shotayagami/jjy-timeserver/hardware/kicad/jjy-hat-pcb-preview.png

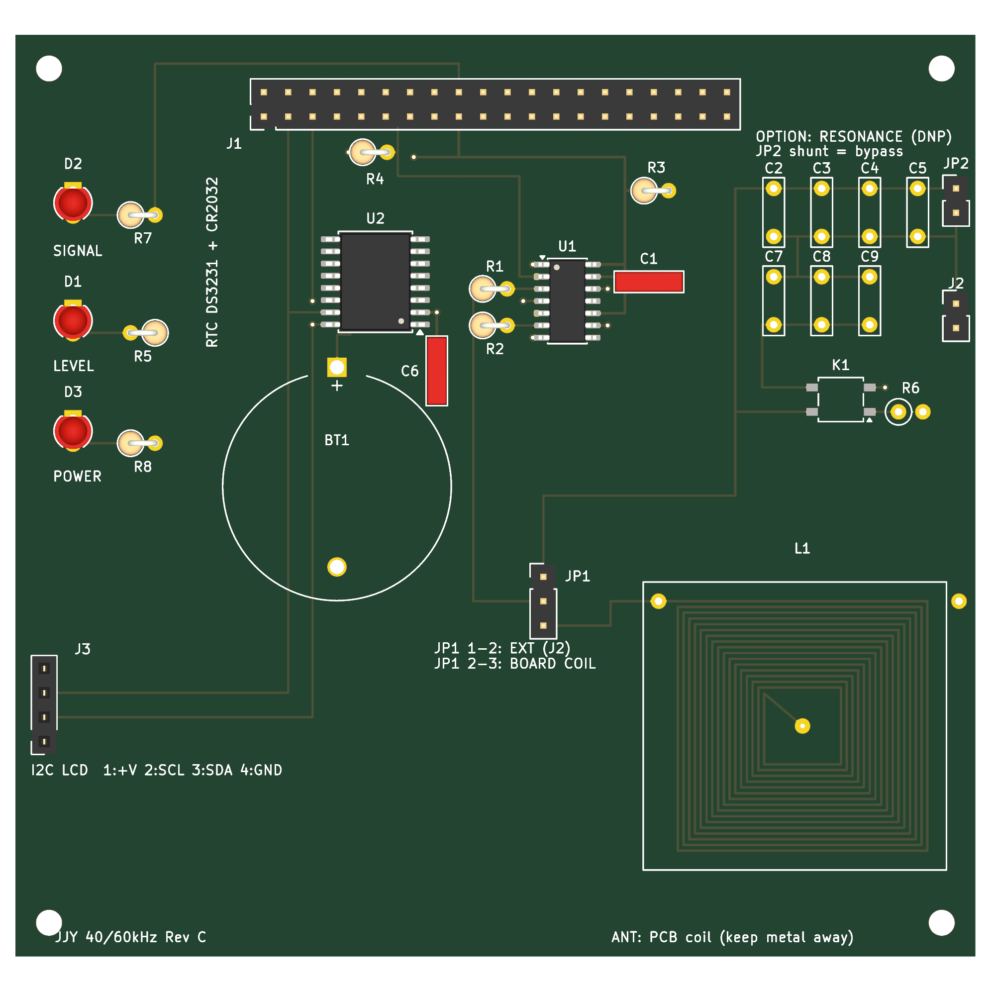
hardware/kicad/jjy-hat-pcb-preview.png
