shotayagami/jjy-timeserver/hardware/kicad/fab/jjy-hat-bom.csv

Designator | Value | Footprint | Qty | DNP
BT1 | CR2032 holder | Battery:BatteryHolder_MYOUNG_BS-07-A1BJ001_CR2032 | 1
C1,C6 | 100n | Capacitor_THT:C_Rect_L7.0mm_W2.0mm_P5.00mm | 2
C2,C7 | 4.7n C0G (DNP) | Capacitor_THT:C_Rect_L7.0mm_W2.0mm_P5.00mm | 2 | 未実装(DNP)
C3,C8,C9 | 2.2n C0G (DNP) | Capacitor_THT:C_Rect_L7.0mm_W2.0mm_P5.00mm | 3 | 未実装(DNP)
C4 | 150p C0G (DNP) | Capacitor_THT:C_Rect_L7.0mm_W2.0mm_P5.00mm | 1 | 未実装(DNP)
C5 | trim (DNP) | Capacitor_THT:C_Rect_L7.0mm_W2.0mm_P5.00mm | 1 | 未実装(DNP)
D1 | LED red | LED_THT:LED_D3.0mm | 1
D2 | LED green | LED_THT:LED_D3.0mm | 1
D3 | LED yellow | LED_THT:LED_D3.0mm | 1
J1 | GPIO 2x20 pin header (ribbon / Dupont) | Connector_PinHeader_2.54mm:PinHeader_2x20_P2.54mm_Vertical | 1
J2 | External antenna | Connector_PinHeader_2.54mm:PinHeader_1x02_P2.54mm_Vertical | 1
J3 | I2C LCD (AE-AQM1602A) | Connector_PinSocket_2.54mm:PinSocket_1x04_P2.54mm_Vertical | 1
JP1 | Antenna select | Connector_PinHeader_2.54mm:PinHeader_1x03_P2.54mm_Vertical | 1
JP2 | Resonance bypass | Connector_PinHeader_2.54mm:PinHeader_1x02_P2.54mm_Vertical | 1
K1 | AQY212SX | Package_SO:SO-4_4.4x4.3mm_P2.54mm | 1
L1 | PCB spiral coil | JJY:Coil_Spiral | 1
R1,R3,R4 | 10k | Resistor_THT:R_Axial_DIN0207_L6.3mm_D2.5mm_P2.54mm_Vertical | 3
R2 | 1.1k | Resistor_THT:R_Axial_DIN0207_L6.3mm_D2.5mm_P2.54mm_Vertical | 1
R5 | 1k | Resistor_THT:R_Axial_DIN0207_L6.3mm_D2.5mm_P2.54mm_Vertical | 1
R6 | 330 (DNP) | Resistor_THT:R_Axial_DIN0207_L6.3mm_D2.5mm_P2.54mm_Vertical | 1 | 未実装(DNP)
R7 | 330 | Resistor_THT:R_Axial_DIN0207_L6.3mm_D2.5mm_P2.54mm_Vertical | 1
R8 | 470 | Resistor_THT:R_Axial_DIN0207_L6.3mm_D2.5mm_P2.54mm_Vertical | 1
U1 | 74LVC125 | Package_SO:SOIC-14_3.9x8.7mm_P1.27mm | 1
U2 | DS3231SN# | Package_SO:SOIC-16W_7.5x10.3mm_P1.27mm | 1
