shotayagami/jjy-timeserver/hardware/kicad/fab/jlcpcb/bom.csv

Comment | Designator | Footprint | LCSC Part #
AQY212SX | K1 | SO-4_4.4x4.3mm_P2.54mm | C719754
74LVC125 | U1 | SOIC-14_3.9x8.7mm_P1.27mm | C7661
DS3231SN# | U2 | SOIC-16W_7.5x10.3mm_P1.27mm | C722469
