shotayagami/jjy-timeserver/hardware/kicad/jjy-hat.kicad_pcb

## KiCad design hardware/kicad/jjy-hat.kicad_pcb (2026-10-30)

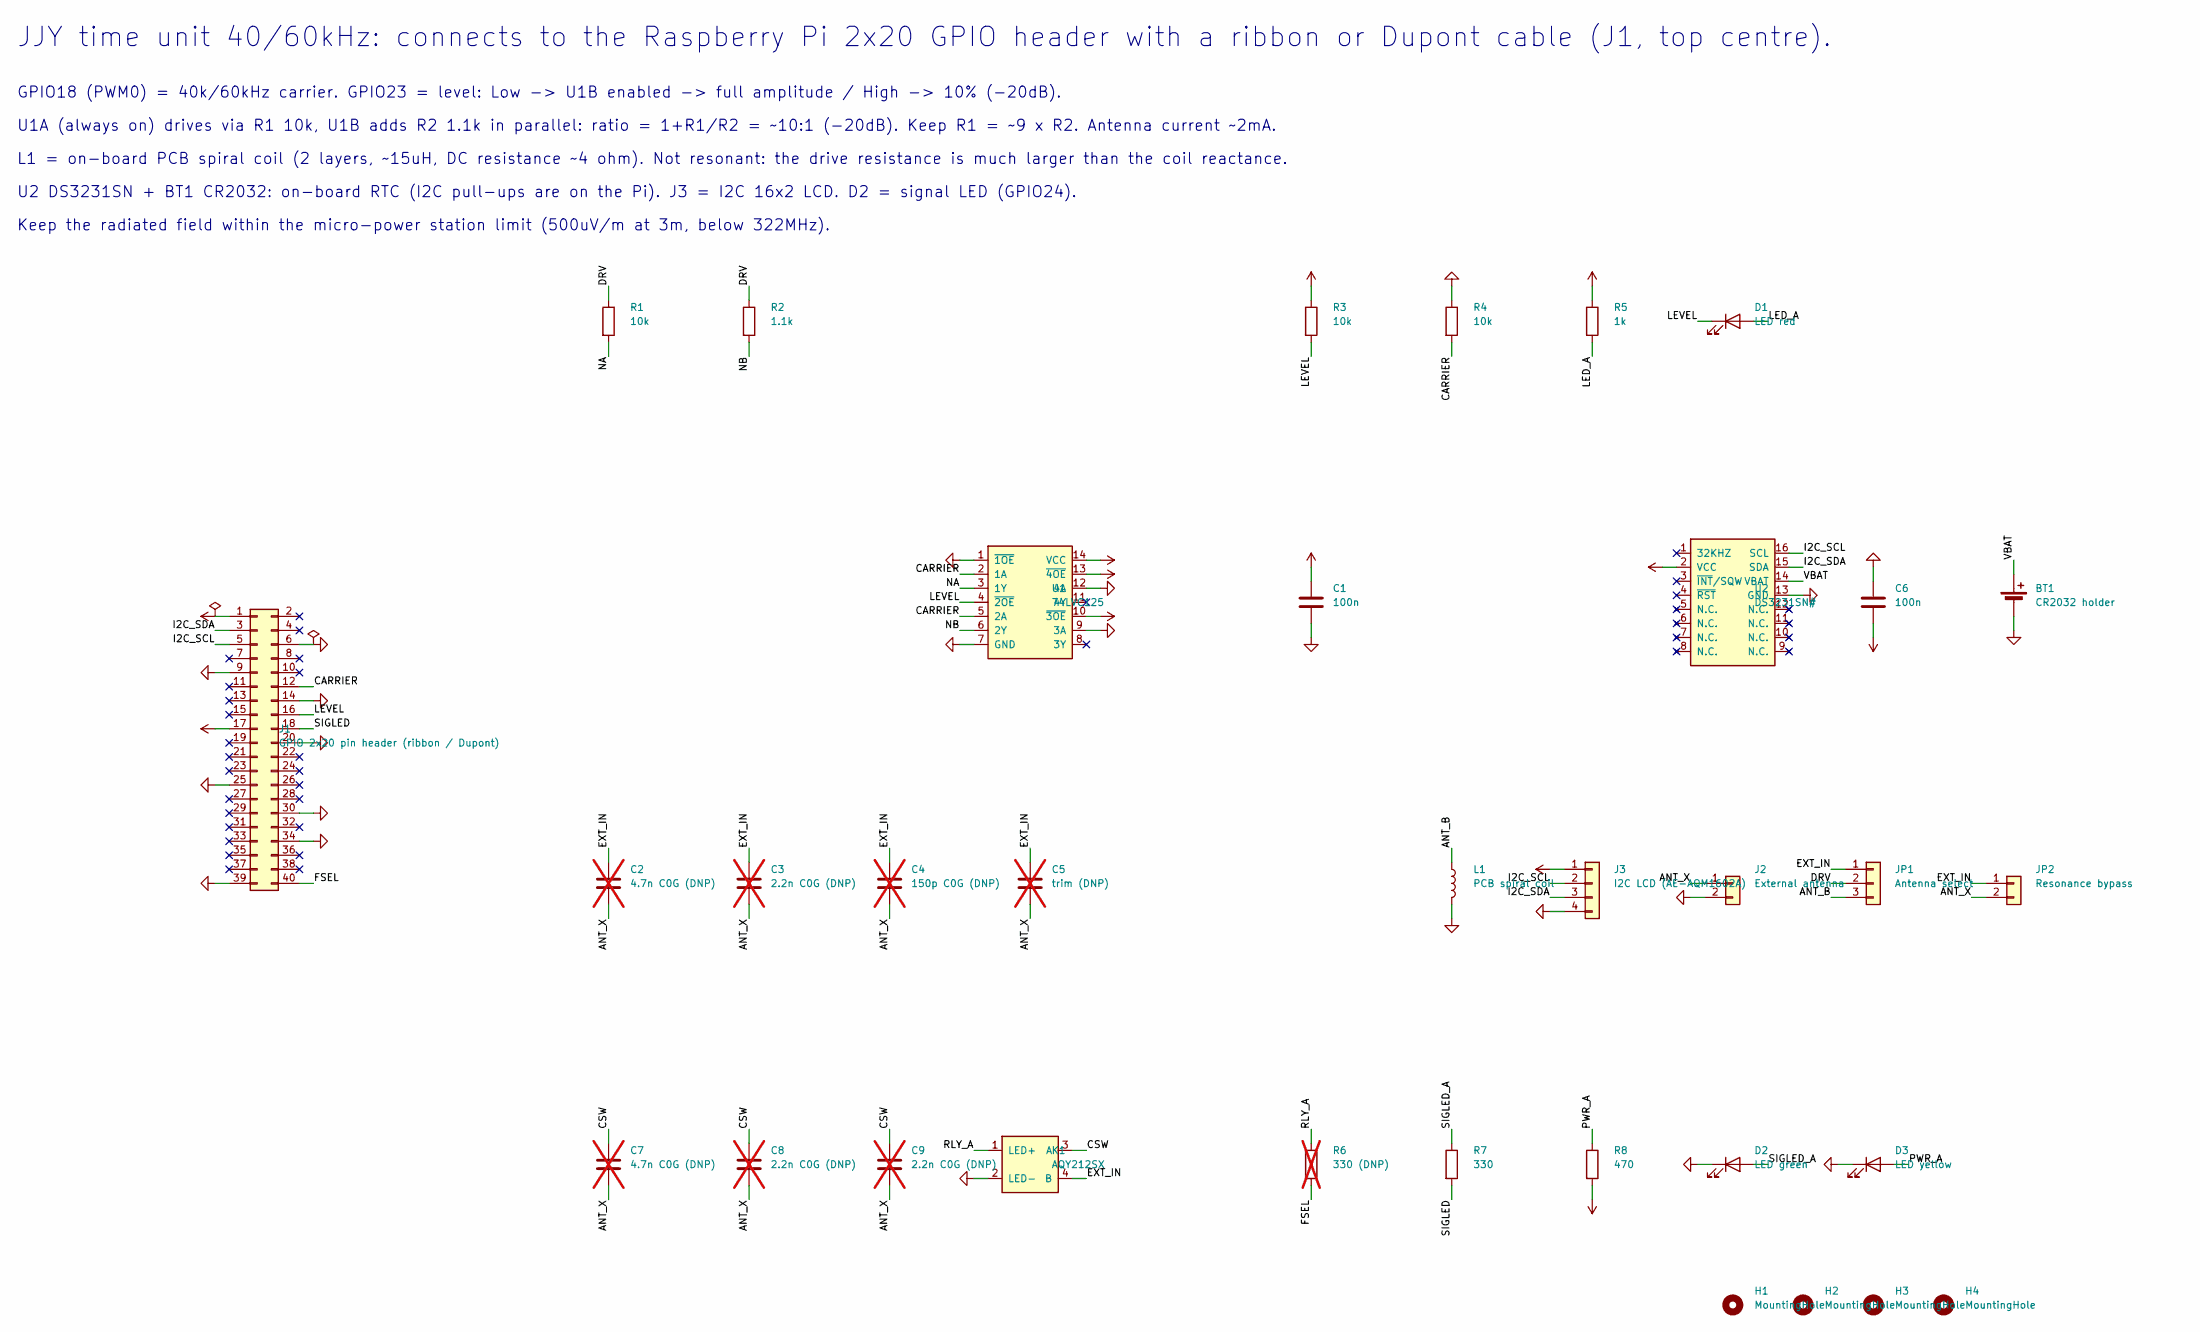
[picture p2: schematic jjy-hat.kicad_sch, JJY time unit 40/60kHz (cable to Raspberry Pi GPIO)]

Parts:
BT1: CR2032 holder; BatteryHolder_MYOUNG_BS-07-A1BJ001_CR2032
C1, C6: 100n; C_Rect_L7.0mm_W2.0mm_P5.00mm
C2, C7: 4.7n C0G (DNP); C_Rect_L7.0mm_W2.0mm_P5.00mm; not fitted
C3, C8, C9: 2.2n C0G (DNP); C_Rect_L7.0mm_W2.0mm_P5.00mm; not fitted
C4: 150p C0G (DNP); C_Rect_L7.0mm_W2.0mm_P5.00mm; not fitted
C5: trim (DNP); C_Rect_L7.0mm_W2.0mm_P5.00mm; not fitted
D1: LED red; LED_D3.0mm
D2: LED green; LED_D3.0mm
D3: LED yellow; LED_D3.0mm
H1, H2, H3, H4: MountingHole; MountingHole_2.7mm_M2.5
J1: GPIO 2x20 pin header (ribbon / Dupont); PinHeader_2x20_P2.54mm_Vertical
J2: External antenna; PinHeader_1x02_P2.54mm_Vertical
J3: I2C LCD (AE-AQM1602A); PinSocket_1x04_P2.54mm_Vertical
JP1: Antenna select; PinHeader_1x03_P2.54mm_Vertical
JP2: Resonance bypass; PinHeader_1x02_P2.54mm_Vertical
K1: AQY212SX; SO-4_4.4x4.3mm_P2.54mm
L1: PCB spiral coil; Coil_Spiral
R1, R3, R4: 10k; R_Axial_DIN0207_L6.3mm_D2.5mm_P2.54mm_Vertical
R2: 1.1k; R_Axial_DIN0207_L6.3mm_D2.5mm_P2.54mm_Vertical
R5: 1k; R_Axial_DIN0207_L6.3mm_D2.5mm_P2.54mm_Vertical
R6: 330 (DNP); R_Axial_DIN0207_L6.3mm_D2.5mm_P2.54mm_Vertical; not fitted
R7: 330; R_Axial_DIN0207_L6.3mm_D2.5mm_P2.54mm_Vertical
R8: 470; R_Axial_DIN0207_L6.3mm_D2.5mm_P2.54mm_Vertical
U1: 74LVC125; SOIC-14_3.9x8.7mm_P1.27mm
U2: DS3231SN#; SOIC-16W_7.5x10.3mm_P1.27mm

Connections:
+3V3: C1.1, C6.2, J1.1, J1.17, J3.1, R3.1, R5.1, R8.2, U1.10 (~3OE), U1.13 (~4OE), U1.14 (VCC), U2.2 (VCC)
/ANT_B: JP1.3, L1.1
/ANT_X: C2.2, C3.2, C4.2, C5.2, C7.2, C8.2, C9.2, J2.1, JP2.2
/CARRIER: J1.12, R4.2, U1.2 (1A), U1.5 (2A)
/CSW: C7.1, C8.1, C9.1, K1.3 (A)
/DRV: JP1.2, R1.1, R2.1
/EXT_IN: C2.1, C3.1, C4.1, C5.1, JP1.1, JP2.1, K1.4 (B)
/FSEL: J1.40, R6.2
/I2C_SCL: J1.5, J3.2, U2.16 (SCL)
/I2C_SDA: J1.3, J3.3, U2.15 (SDA)
/LED_A: D1.2 (A), R5.2
/LEVEL: D1.1 (K), J1.16, R3.2, U1.4 (~2OE)
/NA: R1.2, U1.3 (1Y)
/NB: R2.2, U1.6 (2Y)
/PWR_A: D3.2 (A), R8.1
/RLY_A: K1.1 (LED+), R6.1
/SIGLED: J1.18, R7.2
/SIGLED_A: D2.2 (A), R7.1
/VBAT: BT1.1 (+), U2.14 (VBAT)
GND: BT1.2 (-), C1.2, C6.1, D2.1 (K), D3.1 (K), J1.6, J1.9, J1.14, J1.20, J1.25, J1.30, J1.34, J1.39, J2.2, J3.4, K1.2 (LED-), L1.2, R4.1, U1.1 (~1OE), U1.7 (GND), U1.9 (3A), U1.12 (4A), U2.13 (GND)

Notes on the sheet:
JJY time unit 40/60kHz: connects to the Raspberry Pi 2x20 GPIO header with a ribbon or Dupont cable (J1, top centre).
GPIO18 (PWM0) = 40k/60kHz carrier. GPIO23 = level: Low -> U1B enabled -> full amplitude / High -> 10% (-20dB).
U1A (always on) drives via R1 10k, U1B adds R2 1.1k in parallel: ratio = 1+R1/R2 = ~10:1 (-20dB). Keep R1 = ~9 x R2. Antenna current ~2mA.
L1 = on-board PCB spiral coil (2 layers, ~15uH, DC resistance ~4 ohm). Not resonant: the drive resistance is much larger than the coil reactance.
U2 DS3231SN + BT1 CR2032: on-board RTC (I2C pull-ups are on the Pi). J3 = I2C 16x2 LCD. D2 = signal LED (GPIO24).
Keep the radiated field within the micro-power station limit (500uV/m at 3m, below 322MHz).

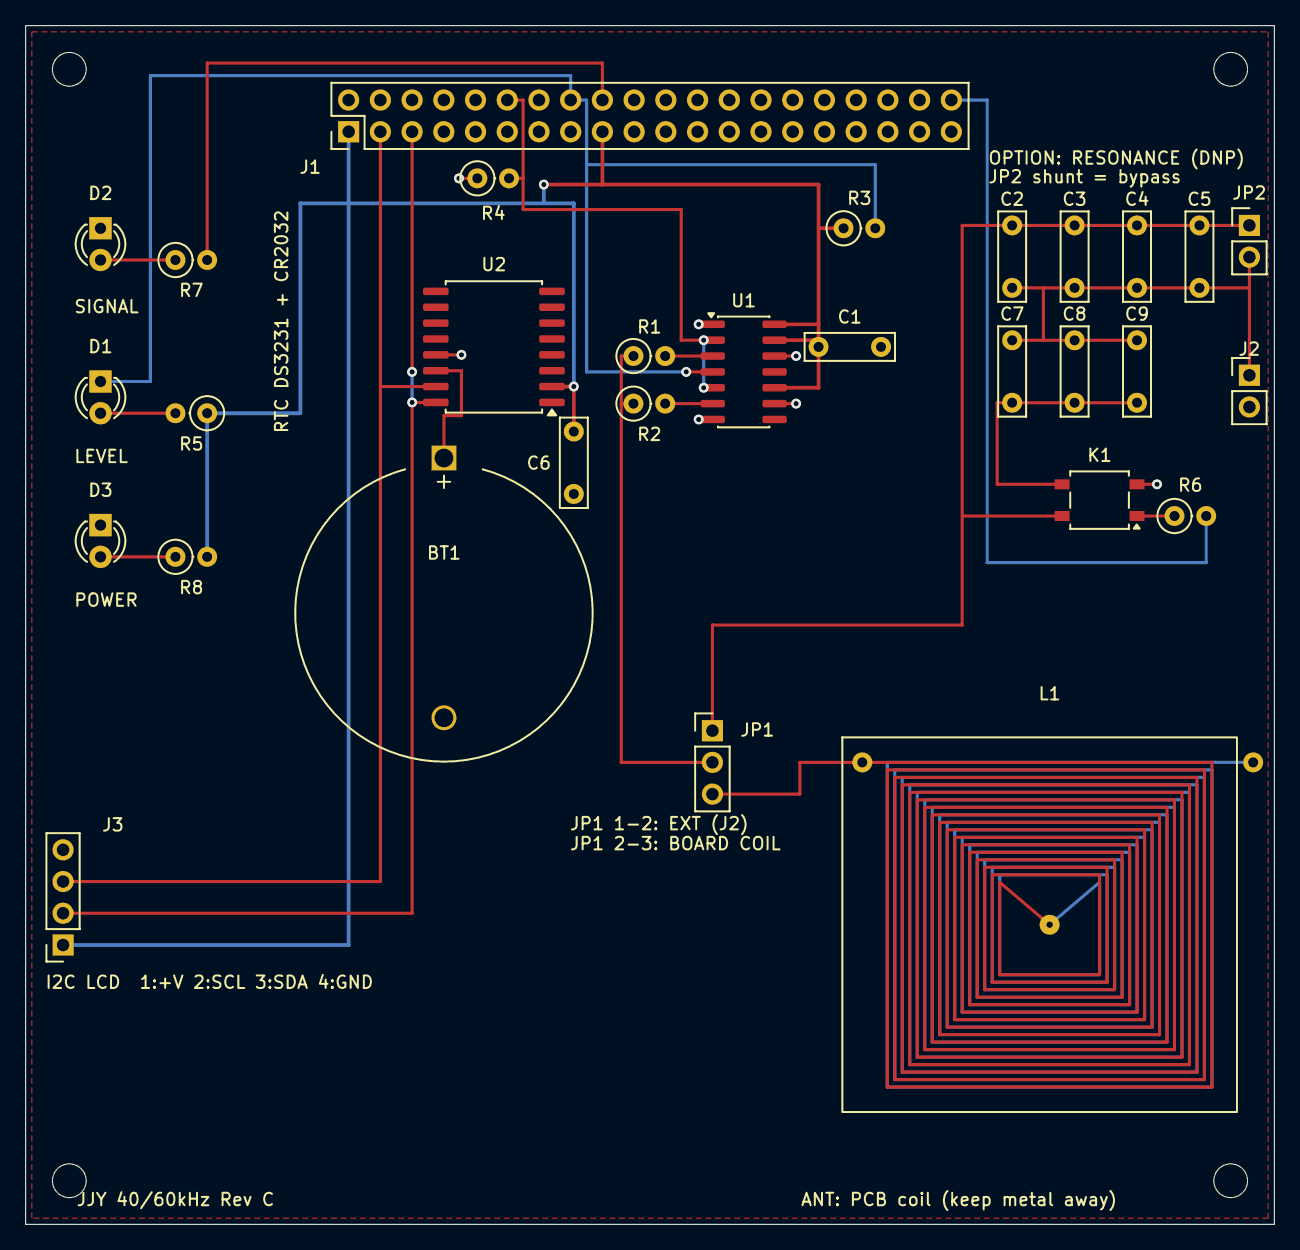
[picture p3: board jjy-hat.kicad_pcb from above]

Board: 2 copper layers, 100.0 x 96.0 mm, 34 parts (0 on the bottom side), 20 nets.
