shotayagami/jjy-timeserver/(commit log)

2026-10-29 Add JJY time server for Raspberry Pi 4: software and 40/60kHz HAT design
    - server/jjyd: JJY time code encoder, transmitter daemon, chrony sync monitor
    with optional DS3231 RTC holdover
    - hardware: KiCad project (generated by hardware/kicad/gen_kicad.py), gerbers,
    JLCPCB BOM/CPL, 40/60kHz photo-MOS band switch, on-board RTC
    - scripts/install.sh, chrony and systemd configuration
    - MIT for software, CERN-OHL-P-2.0 for hardware
    [bom.csv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]
2026-10-30 Rev C board: LCD, LEDs, PCB spiral antenna, antenna select, optional resonance
    - Leaded R/LED/C parts (hand-soldered); only U1/U2 are SMT at JLCPCB
    - 16x2 I2C LCD (J3) shows current time; signal LED (low-level period),
    level LED and power pilot LED grouped at the board's top-left
    - Antenna is an on-board PCB spiral coil; JP1 selects it or external J2
    - Optional (DNP) resonance bank + K1 40/60kHz switch for external coils
    - J1 at top-center, board 100x96 mm to fit the metal case via a cable
    - jjyd: LCD driver, signal LED, optional select_gpio, DS3231 RTC support
    - Regenerated Gerber/BOM/CPL and updated docs
    [bom.csv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]
2026-10-30 Assemble K1 at JLCPCB and list DNP parts in the full BOM
    - K1 (AQY212SX, C719754) is now an SMT part in the JLCPCB BOM/CPL
    - Full BOM keeps DNP parts (C2-C5, C7-C9, R6) with a DNP column
    - Docs updated accordingly; Gerber/BOM/CPL regenerated
    [bom.csv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]
2026-10-30 Align JJY frames with NICT spec: leap seconds, optional call sign
    - Leap seconds: read leap-seconds.list, send LS1/LS2 from the 2nd of the
    previous month, and emit 61-/59-second frames in the final minute
    (60th second is paced on the monotonic clock while the kernel repeats 23:59:59).
    - Call sign minutes (15/45): NICT frame with "JJY" Morse keyed 0%/100% over
    40.0-49.0 s (timing from field measurements) and ST1-ST6 in 50-55 s.
    Disabled by default ([callsign] enabled = false) because "JJY" is NICT's call
    sign and registered trademark; 15/45 then use the normal frame.
    - README: add legal/trademark notes (weak radio station limit, no field-strength
    measurement yet).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
2026-10-31 jjyd: do not transmit from an unsynchronised clock; fix lgpio under ProtectSystem=strict
    Found on the first real Pi 4 (Trixie): after boot jjyd transmitted frames for ~3 min
    from a clock that was 160 s wrong, because
    - chrony's `local stratum 10` makes `chronyc tracking` look synchronised right after start, and
    - after choosing a source chrony only steps the clock minutes later.
    tracking_ok() now rejects the local reference (refid 7F7F0101) and a system-time offset
    above 0.25 s (tests added, verified against live chronyc output on the Pi).
    Also: gpiozero fell back from lgpio because lgpio could not create its pipe files in "/"
    (read-only with ProtectSystem=strict); set WorkingDirectory=/var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
    [timesync.py]
2026-10-31 Add on-screen monitor (jjymon) and jjyd status export
    jjyd writes /run/jjyd/status.json after each second's pulse (carrier, sync
    state, current frame, measured edge timing). jjymon (Tkinter, full screen on
    the Pi's HDMI desktop) shows the JST clock, the live carrier waveform for the
    last 10 s, all 60 frame symbols, an emulation of board LEDs D1/D2/D3, chrony
    tracking and sources, and service/CPU status. install.sh installs the launcher
    and an XDG autostart entry (JJY_MONITOR=0 to skip) and python3-tk.
    [main.py, status.py, timesync.py]
2026-10-31 jjymon: show what each frame bit means
    Each frame cell gets its field colour and bit weight (40/20/10, 8/4/2/1, PA1,
    LS1, P1...), and a table beside the grid lists the fields with the value the
    current frame encodes (minute, hour, day of year, year, weekday, parity check,
    DST, leap-second warning) and highlights the field of the current second.
    Call-sign minutes show JJY and ST1-ST6 instead of year/weekday/LS.
2026-10-31 jjymon: smoother waveform; jjyd --test-callsign-every for call-sign tests
    - Waveform is drawn from exact edge times (per-second symbol records) instead
    of joining 30 Hz samples, and axis labels are only re-rendered when their
    text changes (text redraw dominated the frame time on the Pi: 12 -> ~37 fps).
    - jjyd --dry-run --test-callsign-every N sends call-sign frames every N
    minutes from :00 so the monitor's call-sign display can be tested without
    waiting for :15/:45 (rejected without --dry-run). --status overrides the
    status file path. Publish status once before the 9 s call-sign span.
2026-10-31 jjymon: emulate the board's 16x2 LCD; compact the LED block
    The LCD text is built with jjyd's own format_lines and updated by the same
    rules as jjyd.main.Display (after each pulse's falling edge, not during the
    call-sign seconds, "OFF" when muted). The three LEDs are stacked on the left
    of the transmit panel with the LCD beside them.
